will700/EFS_2023/2. Hardware Components/Hardware Components.xlsx

Sheet: Sheet1
Power Management
For Battery Management System PCB
Item Description | URL from Supplier Website
Phoenix Contact, MSTBA 2.5/ 2-G-5.08, 2 Way, 1 Row, Right Angle PCB Header | https://uk.rs-online.com/web/p/pcb-headers/1896105 | .
Molex, KK 254, 4094, 5 Way, 1 Row, Right Angle Pin Header | https://uk.rs-online.com/web/p/pcb-headers/0468096/?searchHistory=%7B%22enabled%22%3Atrue%7D | .
Molex, KK 254, 4094, 4 Way, 1 Row, Right Angle Pin Header | https://uk.rs-online.com/web/p/pcb-headers/0468080/?searchHistory=%7B%22enabled%22%3Atrue%7D | .
Black Button Tactile Switch, Single Pole Single Throw (SPST) 50 mA @ 24 V dc 1.4мм Surface Mount | https://uk.rs-online.com/web/p/tactile-switches/4791413 | .
771-PSMNR90-40YLHX MOSFETS | https://www.mouser.co.uk/ProductDetail/Nexperia/PSMNR90-40YLHX?qs=Zz7%252BYVVL6bENGG9A3AEHCg%3D%3D | .
604-APA1606SYCK Standard LEDs - SMD Yellow 590nm Water Clear 150mcd | https://www.mouser.co.uk/ProductDetail/Kingbright/APA1606SYCK?qs=f499HRGa1RlTUe7hvb0qBw%3D%3D | .
MAX17320G20+ | https://www.mouser.co.uk/ProductDetail/Maxim-Integrated/MAX17320G20%2b?qs=sPbYRqrBIVnSGVqLjzq7LQ%3D%3D | .
ESP12F | https://www.mouser.co.uk/ProductDetail/Adafruit/2491?qs=N%2F3wi2MvZWDVFv7HwruvGQ%3D%3D | .
Texas Instruments REG1117-3.3, 1 Low Dropout Voltage, Voltage Regulator 800mA, 3.3 V 3+Tab-Pin, SOT-223 | https://uk.rs-online.com/web/p/voltage-regulators/6200852 | .
Current Sense Resistors - SMD 10W 0.005 OHM 1 % | https://www.mouser.co.uk/ProductDetail/Ohmite/FCSL150R005FER?qs=sGAEpiMZZMtlubZbdhIBIORfomlZPkvN5vJkk8KbYhA%3D | .
10 OHM 0603 resistor | https://uk.rs-online.com/web/p/surface-mount-resistors/2132008 | .
1 KOHM 0603 resistor | https://uk.rs-online.com/web/p/surface-mount-resistors/2132266 | .
4k7 OHM 0603 resistor | https://uk.farnell.com/multicomp/mcwr06x4701ftl/res-4k7-1-0-1w-0603-thick-film/dp/2447385?mckv=_dc|pcrid||plid||kword||match||slid||product|2447385|pgrid||ptaid|&CMP=KNC-GUK-GEN-SHOPPING-SMART-PMAX-Low_ROAS-Test990&gross_price=true | .
10k OHM 0603 resistor | https://uk.rs-online.com/web/p/surface-mount-resistors/7408805?matchtype=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 | .
50 OHM 2512 resistor | https://uk.rs-online.com/web/p/surface-mount-resistors/8802191 | .
0.01 uF 0603 Capacitor | https://uk.farnell.com/yageo/cc0603krx7r8bb103/cap-0-01-f-25v-10-x7r-0603/dp/3019561 | .
0.47 uF 0603 Capacitor | https://uk.farnell.com/tdk/c1608x7r1h474k080ac/cap-0-47-f-50v-10-x7r-0603/dp/2346908 | .
10 uF 0603 Capacitor | https://uk.farnell.com/tdk/c1608x5r1a106k080ac/cap-10-f-10v-10-x5r-0603/dp/2211164 | .
100 nF 0603 Capacitor | https://uk.farnell.com/tdk/cga3e2x7r1h104k080aa/cap-0-1-f-50v-10-x7r-0603/dp/2346967 | .
For more information on the wiring and the placement of these components, check the PCB schematic and files uploaded on the github
Specific information on the layout used for guidance can be seen in the data sheet of the MAX17320G20+ at https://www.mouser.co.uk/ProductDetail/Analog-Devices-Maxim-Integrated/MAX17320G20%2b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 | .
For more information contact:
Mark Gad: markgad001@gmail.com

Sheet: Sheet2
Power Management
For Charger PCB
Item Description | URL from Supplier Website
Texas Instruments LM2937ET-3.3/NOPB, 1 Low Dropout Voltage, Voltage Regulator 500mA, 3.3 V 3-Pin, TO-220 | https://uk.rs-online.com/web/p/voltage-regulators/1025697 | .
Black Button Tactile Switch, Single Pole Single Throw (SPST) 50 mA @ 24 V dc 1.4мм Surface Mount | https://uk.rs-online.com/web/p/tactile-switches/4791413 | .
Panasonic 10kΩ, 0603 (1608M) Thick Film SMD Resistor ±1% 0.25W - ERJPA3F1002V | https://uk.rs-online.com/web/p/surface-mount-resistors/1724205 | .
Bourns 10mΩ, 0603 (1608M) Metal Foil SMD Resistor 1% 0.5W - CFN0603-FX-R010ELF | https://uk.rs-online.com/web/p/surface-mount-resistors/2437719 | .
RS PRO 430kΩ, 0603 (1608M) Thick Film SMD Resistor ±1% 0.1W | https://uk.rs-online.com/web/p/surface-mount-resistors/8049056 | .
TE Connectivity 66.5kΩ, 0603 (1608M) Thin Film SMD Resistor ±0.1% 0.063W - CPF0603B66K5E1 | https://uk.rs-online.com/web/p/surface-mount-resistors/1229591 | .
Vishay 100kΩ, 0603 (1608M) Thick Film SMD Resistor ±1% 0.25W - CRCW0603100KFKEAHP | https://uk.rs-online.com/web/p/surface-mount-resistors/8206745 | .
RS PRO 316kΩ, 0603 (1608M) Thick Film SMD Resistor ±1% 0.1W | https://uk.rs-online.com/web/p/surface-mount-resistors/7171415 | .
Vishay 10Ω, 0603 (1608M) Thick Film SMD Resistor ±5% 0.1W - CRCW060310R0JNEAIF | https://uk.rs-online.com/web/p/surface-mount-resistors/8206922 | .
755-UCR01MVPJLR47 | https://www.mouser.com/ProductDetail/ROHM-Semiconductor/UCR01MVPJLR47 | .
UCR01MVPJLR47 | https://www.mouser.com/ProductDetail/ROHM-Semiconductor/UCR01MVPJLR47 | .
TE Connectivity 39.2kΩ, 0603 (1608M) Thin Film SMD Resistor ±0.1% 0.063W - CPF0603B39K2E1 | https://uk.rs-online.com/web/p/surface-mount-resistors/1228843 | .
MOSFET Vishay SIS412DN-T1-GE3 | https://uk.rs-online.com/web/p/mosfets/1807909 | .
604-APA1606SYCK | https://www.mouser.com/ProductDetail/Kingbright/APA1606SYCK?qs=f499HRGa1RlTUe7hvb0qBw%3D%3D | .
710-744771004 | https://www.mouser.com/ProductDetail/Wurth-Elektronik/744771004?qs=E%2F%2FhvbtCqpOcXjC2TM64Zg%3D%3D | .
Phoenix Contact, MSTBA 2.5/ 2-G-5.08, 2 Way, 1 Row, Right Angle PCB Heade | https://uk.rs-online.com/web/p/pcb-headers/1896105 | .
Diodes Inc 30V 200mA, Schottky Diode, 3-Pin SOT-23 BAT54-7-F | https://uk.rs-online.com/web/p/schottky-diodes-rectifiers/7384829 | .
KEMET, 1206 (3216M) 2.2μF Multilayer Ceramic Capacitor MLCC 50V dc ±10% , SMD C1206C225K5RACTU | https://uk.rs-online.com/web/p/mlccs-multilayer-ceramic-capacitors/6911215 | .
Murata, 0603 (1608M) 10μF Multilayer Ceramic Capacitor MLCC 25V dc ±20% , SMD GRM188R61E106MA73D | https://uk.rs-online.com/web/p/mlccs-multilayer-ceramic-capacitors/8151377 | .
KEMET, 0603 (1608M) 100nF Multilayer Ceramic Capacitor MLCC 16V dc ±10% , SMD C0603C104K4RACTU | https://uk.rs-online.com/web/p/mlccs-multilayer-ceramic-capacitors/2644630 | .
Murata, 0603 (1608M) 1μF Multilayer Ceramic Capacitor MLCC 25V dc ±10% , SMD GCM188R71E105KA64D | https://uk.rs-online.com/web/p/mlccs-multilayer-ceramic-capacitors/7234972 | .
KEMET, 0603 (1608M) 100pF Multilayer Ceramic Capacitor MLCC 50V dc ±5% , SMD C0603C101J5GACTU | https://uk.rs-online.com/web/p/mlccs-multilayer-ceramic-capacitors/2644523 | .
KYOCERA AVX, 0603 (1608M) 47nF Multilayer Ceramic Capacitor MLCC 16V dc ±10% , SMD 0603YC473KAT2A | https://uk.rs-online.com/web/p/mlccs-multilayer-ceramic-capacitors/0391220 | .
BQ24707RGRT Chip | https://uk.farnell.com/texas-instruments/bq24707rgrt/ic-battery-charger-li-ion-8a-vqfn/dp/3123801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 | .
For more information on the wiring and the placement of these components, check the PCB schematic and files uploaded on the github.
Specific information on the layout used for guidance can be seen in the data sheet of the BQ24707RGRT found in https://www.mouser.co.uk/ProductDetail/Texas-Instruments/BQ24707RGRT?qs=Ze4%2FuFuz19K%252BTlg9cQ87mw%3D%3D |  | .
for more information contact:
Josiah Edebiri: jedebiri7@outlook.com

Sheet: Sheet3
Autonomous Flight
Item Description | URL from Supplier Website
Raspberry Pi | https://www.amazon.co.uk/Raspberry-Pi-Model-4GB/dp/B09TTKT94J | .
DFRobot, , USB 2.0 with 3280 x 2464 pixels Resolution | https://uk.rs-online.com/web/p/raspberry-pi-cameras/2473234 | .
Holybro Pixhawk 4 Mini PX4 Autopilot Board with PM & GPS | https://www.flyingtech.co.uk/electronics/holybro-pixhawk-4-mini-px4-fc-autopilot-pm06-v2-gps | .
For more information contact:
Charles Chittilappilly: charlesshaju@outlook.com
William Talbott: wtal700@gmail.com
