will700/EFS_2023/4. CAD files and Assemblies/13a th Assembly/WDS568-219-STEP-AP203/WDS568-219.step

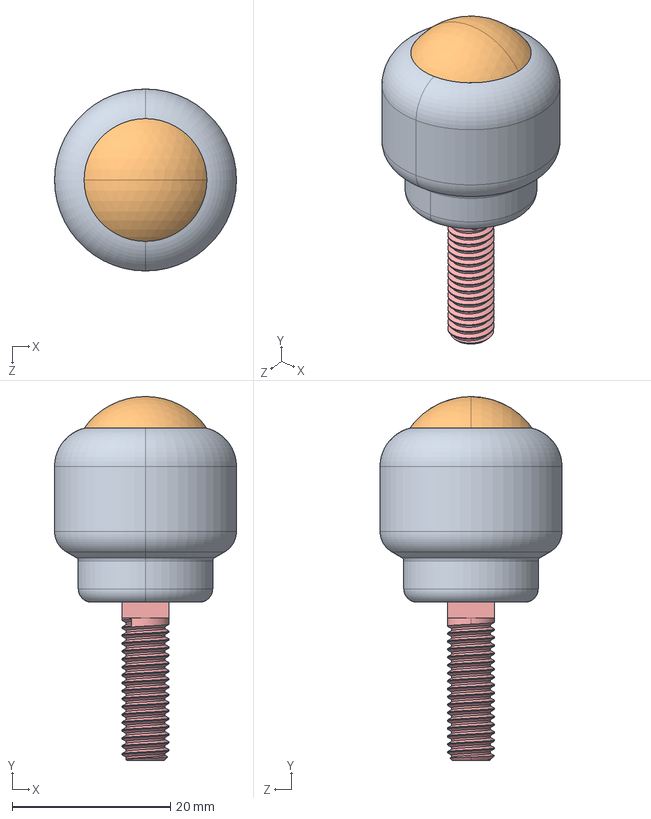
[picture p1: CAD file, 2023-06-09]
4. CAD files and Assemblies/13a th Assembly/WDS568-219-STEP-AP203/WDS568-219.step
23.0 x 46.0 x 23.0 mm
WDS568-219-P1_19.05
WDS568-219-P2_19.05
WDS568-219-P2_2 x 5
WDS568-219-P3_19.05
WDS568-219-P4_M6-20
