will700/EFS_2023/4. CAD files and Assemblies/Four Assembly/6002-z-bnl v1.step

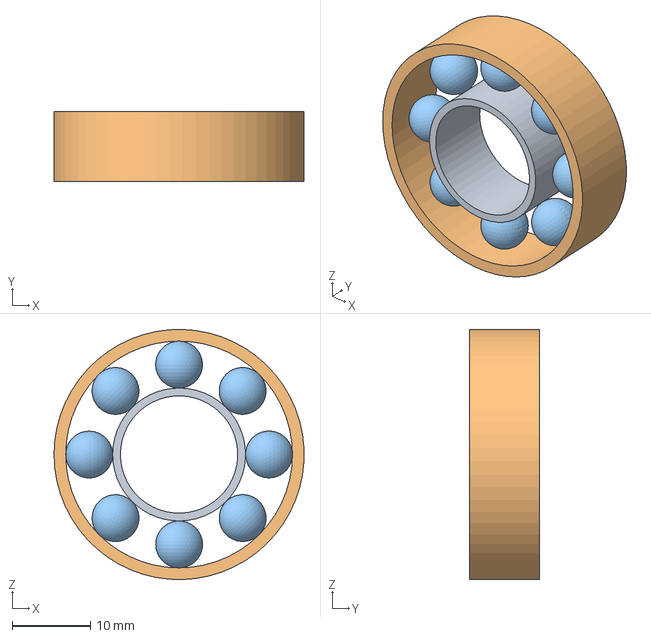
[picture p2: CAD file, 2023-06-09]
4. CAD files and Assemblies/Four Assembly/6002-z-bnl v1.step
32.0 x 9.00 x 32.0 mm
