will700/EFS_2023/(list of files, cad)

Other CAD files:
4. CAD files and Assemblies/13a th Assembly/6002-z-bnl v1.ipt
4. CAD files and Assemblies/13a th Assembly/BHSS.iam
4. CAD files and Assemblies/13a th Assembly/Base Plate V2/Base Plate Assembly.iam
4. CAD files and Assemblies/13a th Assembly/Base Plate V2/Base Plate Wall 1.ipt
4. CAD files and Assemblies/13a th Assembly/Base Plate V2/Base Plate.ipt
4. CAD files and Assemblies/13a th Assembly/Battery Cage Assembly.iam
4. CAD files and Assemblies/13a th Assembly/Battery Cage Second Iteration.ipt
4. CAD files and Assemblies/13a th Assembly/Battery Cage Spring Plate Second Iteration.ipt
4. CAD files and Assemblies/13a th Assembly/Battery Cage Spring Plate.ipt
4. CAD files and Assemblies/13a th Assembly/Battery Cage and Spring Plate.iam
4. CAD files and Assemblies/13a th Assembly/Battery Cage.ipt
4. CAD files and Assemblies/13a th Assembly/Battery Container.ipt
4. CAD files and Assemblies/13a th Assembly/Battery_Module_Second_Iteration.ipt
4. CAD files and Assemblies/13a th Assembly/Box Base Plate.ipt
4. CAD files and Assemblies/13a th Assembly/Carousel Base Plate Assembly.iam
4. CAD files and Assemblies/13a th Assembly/Carousel Base Plate Laser Cut/Base Plate Bottom v3.ipt
4. CAD files and Assemblies/13a th Assembly/Carousel Base Plate Laser Cut/Base Plate Laser Assembly.iam
4. CAD files and Assemblies/13a th Assembly/Carousel Base Plate Laser Cut/Base Plate Wall.ipt
4. CAD files and Assemblies/13a th Assembly/Carousel Base Plate Laser Cut/base Plate Laser Full Carou ASSEMBLY.iam
4. CAD files and Assemblies/13a th Assembly/Carousel Base Plate v2.ipt
4. CAD files and Assemblies/13a th Assembly/Full Carousel Assembly.iam
4. CAD files and Assemblies/13a th Assembly/Inner Circle Landing Legs.ipt
4. CAD files and Assemblies/13a th Assembly/Landing Docks Assembly .iam
4. CAD files and Assemblies/13a th Assembly/Landing Docks Upper Module.ipt
4. CAD files and Assemblies/13a th Assembly/Landing docks legs.ipt
4. CAD files and Assemblies/13a th Assembly/MC_Plate.ipt
4. CAD files and Assemblies/13a th Assembly/Moving Carousel Assembky.iam
4. CAD files and Assemblies/13a th Assembly/Moving Carousel Single.iam
4. CAD files and Assemblies/13a th Assembly/Moving Carousel V3.ipt
4. CAD files and Assemblies/13a th Assembly/Moving Carousel/Moving Caoursel Base.ipt
4. CAD files and Assemblies/13a th Assembly/Moving Carousel/Moving Caoursel base Clip.ipt
4. CAD files and Assemblies/13a th Assembly/Moving Carousel/Moving Carousel Assembly.iam
4. CAD files and Assemblies/13a th Assembly/Moving Carousel/Moving Carousel Base Inner Clip.ipt
4. CAD files and Assemblies/13a th Assembly/Moving Carousel/Moving Carousel Section Assembly.iam
4. CAD files and Assemblies/13a th Assembly/Moving Carousel/Moving Carousel Upper.ipt
4. CAD files and Assemblies/13a th Assembly/Moving Carousel/Moving Carousel Wall.ipt
4. CAD files and Assemblies/13a th Assembly/WDS568-219-STEP-AP203/OldVersions/WDS568-219.0002.ipt
4. CAD files and Assemblies/13a th Assembly/WDS568-219-STEP-AP203/WDS568-219.ipt
4. CAD files and Assemblies/13a th Assembly/drone model.ipt
4. CAD files and Assemblies/Eighth Assembly/BHSS.iam
4. CAD files and Assemblies/Eighth Assembly/Carousel Container Plate.ipt
4. CAD files and Assemblies/Eighth Assembly/Carousel Fixed Track.ipt
4. CAD files and Assemblies/Eighth Assembly/Full Roller Carousel Assembly.iam
4. CAD files and Assemblies/Eighth Assembly/Inner Circle Landing Legs.ipt
4. CAD files and Assemblies/Eighth Assembly/Landing dock V2.ipt
4. CAD files and Assemblies/Eighth Assembly/OldVersions/BHSS.0037.iam
4. CAD files and Assemblies/Eighth Assembly/OldVersions/Ball Transfer Unit Assembly.0002.iam
4. CAD files and Assemblies/Eighth Assembly/OldVersions/Battery Container.0013.ipt
4. CAD files and Assemblies/Eighth Assembly/OldVersions/Box Base Plate.0005.ipt
4. CAD files and Assemblies/Eighth Assembly/OldVersions/Carousel Container Plate.0012.ipt
4. CAD files and Assemblies/Eighth Assembly/OldVersions/Full Roller Carousel Assembly.0002.iam
4. CAD files and Assemblies/Eighth Assembly/OldVersions/Inner Circle Landing Legs.0004.ipt
4. CAD files and Assemblies/Eighth Assembly/OldVersions/Roller Carouel Assembly.0013.iam
4. CAD files and Assemblies/Eighth Assembly/OldVersions/Roller Carousel Part.0010.ipt
4. CAD files and Assemblies/Eighth Assembly/OldVersions/ball transfer unit base.0004.ipt
4. CAD files and Assemblies/Eighth Assembly/OldVersions/ball transfer unit.0005.ipt
4. CAD files and Assemblies/Eighth Assembly/Roller Carouel Assembly.iam
4. CAD files and Assemblies/Eighth Assembly/Roller Carousel Gear.ipt
4. CAD files and Assemblies/Eighth Assembly/Roller Carousel Part.ipt
4. CAD files and Assemblies/Final Assembly/BHSS.iam
4. CAD files and Assemblies/Final Assembly/Base Plate/Base Plate.ipt
4. CAD files and Assemblies/Final Assembly/Base Plate/OldVersions/Base Plate Assembly.0004.iam
4. CAD files and Assemblies/Final Assembly/Base Plate/OldVersions/Base Plate Demo.0012.ipt
4. CAD files and Assemblies/Final Assembly/Base Plate/OldVersions/Base Plate.0002.ipt
4. CAD files and Assemblies/Final Assembly/Base Plate/OldVersions/Base Plate.0003.ipt
4. CAD files and Assemblies/Final Assembly/Battery Cage and Sprind Plate/Battery Cage Assembly.iam
4. CAD files and Assemblies/Final Assembly/Battery Cage and Sprind Plate/Battery Cage.ipt
4. CAD files and Assemblies/Final Assembly/Battery Cage and Sprind Plate/Spring Plate.ipt
4. CAD files and Assemblies/Final Assembly/Battery Module/Battery Module Back Panel.ipt
4. CAD files and Assemblies/Final Assembly/Battery Module/Battery Module Bottom Plate.ipt
4. CAD files and Assemblies/Final Assembly/Battery Module/Battery Module Inner Wall.ipt
4. CAD files and Assemblies/Final Assembly/Battery Module/Battery Module Outer Wall.ipt
4. CAD files and Assemblies/Final Assembly/Battery Module/Battery Module Top Plate.ipt
4. CAD files and Assemblies/Final Assembly/Battery Module/Battery Module Top Wing.ipt
4. CAD files and Assemblies/Final Assembly/Battery Module/Battery Module with Battery Cage.iam
4. CAD files and Assemblies/Final Assembly/Battery Module/Battery Module.iam
4. CAD files and Assemblies/Final Assembly/Battery Module/Connector Plate.ipt
4. CAD files and Assemblies/Final Assembly/Battery Module/Female Blade Component.ipt
4. CAD files and Assemblies/Final Assembly/Battery Module/Male Blade Connectors Plate.ipt
4. CAD files and Assemblies/Final Assembly/Battery Module/UAV Battery.ipt
4. CAD files and Assemblies/Final Assembly/Busbar/Busbar Assembly.iam
4. CAD files and Assemblies/Final Assembly/Busbar/Busbar Base.ipt
4. CAD files and Assemblies/Final Assembly/Busbar/Busbar Copper.ipt
4. CAD files and Assemblies/Final Assembly/Cable holder/bottom card holder.ipt
4. CAD files and Assemblies/Final Assembly/Cable holder/upper card holder.ipt
4. CAD files and Assemblies/Final Assembly/Complete Carousel Assembly.iam
4. CAD files and Assemblies/Final Assembly/Drone_Model.ipt
4. CAD files and Assemblies/Final Assembly/Landing Docks/Base of Landing Docks.ipt
4. CAD files and Assemblies/Final Assembly/Landing Docks/Landing Dock Legs.ipt
4. CAD files and Assemblies/Final Assembly/Landing Docks/Landing Docks Assembly.iam
4. CAD files and Assemblies/Final Assembly/Landing Docks/Landing Docks Funnel .ipt
4. CAD files and Assemblies/Final Assembly/Motor Casing/Motor Assembly.iam
4. CAD files and Assemblies/Final Assembly/Motor Casing/Motor Case.ipt
4. CAD files and Assemblies/Final Assembly/Motor Casing/Motor Gear Connector.ipt
4. CAD files and Assemblies/Final Assembly/Motor Casing/Motor Gear.ipt
4. CAD files and Assemblies/Final Assembly/Motor Casing/Motor Model.ipt
4. CAD files and Assemblies/Final Assembly/Non-Rotating Carousel/Base Plate Bottom v3.ipt
4. CAD files and Assemblies/Final Assembly/Non-Rotating Carousel/Base Plate Wall.ipt
4. CAD files and Assemblies/Final Assembly/Non-Rotating Carousel/Non-Rotating Carousel Assembly.iam
4. CAD files and Assemblies/Final Assembly/Non-Rotating Carousel/Non-Rotating Carousel Plate.ipt
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
