will700/EFS_2023/4. CAD files and Assemblies/13a th Assembly/WDS568-219-STEP-AP203/readme.txt

(V1001) 04/05/2022 11:40:58 date generated by WDS

STEP AP203

The part number you downloaded was: 568-219

This model was downloaded from WDSComponents.com
Visit us online for more free 3D & 2D models and drawings

If you have any issues, please contact cadhelp@wdscomponents.com
