will700/EFS_2023/(commit log)

2023-06-09 Rename Software Components/batt_swap.py to Software Components/Motor Control/batt_swap.py
2023-06-09 Rename Software Components/bss_align.py to Software Components/Motor Control/bss_align.py
2023-06-09 Rename Software Components/bss_master.py to Software Components/Motor Control/bss_master.py
2023-06-09 Rename Software Components/my_module.py to Software Components/Motor Control/my_module.py
2023-06-09 Rename Software Components/test.launch to Software Components/Motor Control/test.launch
